MateuszTk/Excavator-Leveling/controller/controller/buttons.h

#ifndef BUTTONS_H_
#define BUTTONS_H_

#include <avr/io.h>

#define BUTTON_UP_DDR DDRD
#define BUTTON_UP_PORT PORTD
#define BUTTON_UP_PIN PIND
#define BUTTON_UP PD5

#define BUTTON_DOWN_DDR DDRD
#define BUTTON_DOWN_PORT PORTD
#define BUTTON_DOWN_PIN PIND
#define BUTTON_DOWN PD4

#define BUTTON_OK_DDR DDRD
#define BUTTON_OK_PORT PORTD
#define BUTTON_OK_PIN PIND
#define BUTTON_OK PD6

#define SWITCH_ARMED_DDR DDRD
#define SWITCH_ARMED_PORT PORTD
#define SWITCH_ARMED_PIN PIND
#define SWITCH_ARMED PD7

void buttons_init(){
    BUTTON_UP_DDR &= ~(1 << BUTTON_UP);
    BUTTON_UP_PORT |= (1 << BUTTON_UP);
    
    BUTTON_DOWN_DDR &= ~(1 << BUTTON_DOWN);
    BUTTON_DOWN_PORT |= (1 << BUTTON_DOWN);
    
    BUTTON_OK_DDR &= ~(1 << BUTTON_OK);
    BUTTON_OK_PORT |= (1 << BUTTON_OK);

    SWITCH_ARMED_DDR &= ~(1 << SWITCH_ARMED);
    SWITCH_ARMED_PORT |= (1 << SWITCH_ARMED);
}

uint8_t button_up(){
    return !(BUTTON_UP_PIN & (1 << BUTTON_UP));
}

uint8_t button_down(){
    return !(BUTTON_DOWN_PIN & (1 << BUTTON_DOWN));
}

uint8_t button_ok(){
    return !(BUTTON_OK_PIN & (1 << BUTTON_OK));
}

uint8_t switch_armed(){
    return !(SWITCH_ARMED_PIN & (1 << SWITCH_ARMED));
}

#endif /* BUTTONS_H_ */
