MateuszTk/Excavator-Leveling/controller/controller/eeprom.h

#ifndef EEPROM_H_
#define EEPROM_H_

unsigned char EEPROM_read(unsigned int uiAddress)
{
	/* Wait for completion of previous write */
	while(EECR & (1<<EEPE))
	;
	/* Set up address register */
	EEAR = uiAddress;
	/* Start eeprom read by writing EERE */
	EECR |= (1<<EERE);
	/* Return data from Data Register */
	return EEDR;
}

void EEPROM_write(unsigned int uiAddress, unsigned char ucData)
{
	/* Wait for completion of previous write */
	while(EECR & (1<<EEPE)) ;
	
	unsigned char current = EEPROM_read(uiAddress);
	if (current != ucData){
		/* Set up address and Data Registers */
		EEAR = uiAddress;
		EEDR = ucData;
		/* Write logical one to EEMPE */
		EECR |= (1<<EEMPE);
		/* Start eeprom write by setting EEPE */
		EECR |= (1<<EEPE);
	}
}

#endif /* EEPROM_H_ */
